Ueberspannung/Smoky/README.md

# Smoky
small hand-held smoke machine

Did you ever needed a small smoke machine for testing air flow in a computer case or around heat sinks?  
Well here it is:

## the smoke machine to go
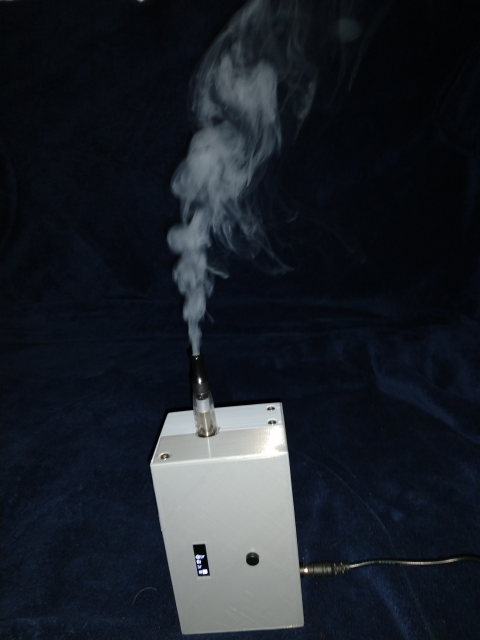
[picture p1: doc/img/thumb/assembly/640/Smoky_active.png]
smoky

- hand held ~ 83 x 64 x 132 (184) mm
- adjustable smoke output
- pulse mode (steam engine effect) 
- 128 x 32 oled with 5 way navigation button
- operating voltage 8-24V
- input voltage low detection

I tried it on smoke detectors: I works!  
> [!WARNING]  
> As the smoke is rather fog than smoke it consists of vaporized liquids which 
> may cause a residue in your smoke detector. Make shure to blow out the smoke 
> with compressed air after the test.  

##### Table of contents
- [motivation](#motivation)
- [hardware](./doc/hw.md#Table-of-contents)
	- [schematics](./doc/hw.md#schematics)
	- [parts](./doc/hw.md#parts)
	- [assembly](./doc/hw.md#assembly)
- [software](./doc/sw.md#Table-of-contents)
- [operation](./doc/operation.md#Table-of-contents)
	- [smoke liquid](./doc/operation.md#smoke-liquid)
	- [principle of operation](./doc/operation.md#principle-of-operation)
	- [menu icons](./doc/operation.md#menu-icons)
	- [menu structure](./doc/operation.md#menu-structure)

## motivation
while looking for a ready build smoke machine for air flow analyses I found  
- chinese smoke machines for party use for less then 30€, which are far to powerfull  
- small smoke machines for the intended use starting at ~50€ with usable models well above 100€  
- smoke machines for your garden model trains starting at ~ 100€  

I thougt the model smoke machines should be the right way to go. In an platform for railway modellists 
I found a hint to use an e-cigarette. This sounded plausible and I decided that this was the way to go. So I 
searched for e-cigarette, and parts. I found some cheap vape heads and added an usb powerd fish tank air pump.  
The concept was born  
To make it operational, I had to ad a PWM control for air flow and steam generation, a UI and a case,
For details see [hardware](./doc/hw.md#Table-of-contents) and the functional [description](./doc/operation.md#Table-of-contents)
