Ueberspannung/Smoky/doc/img/src/menu/Menu_1_0________main.png

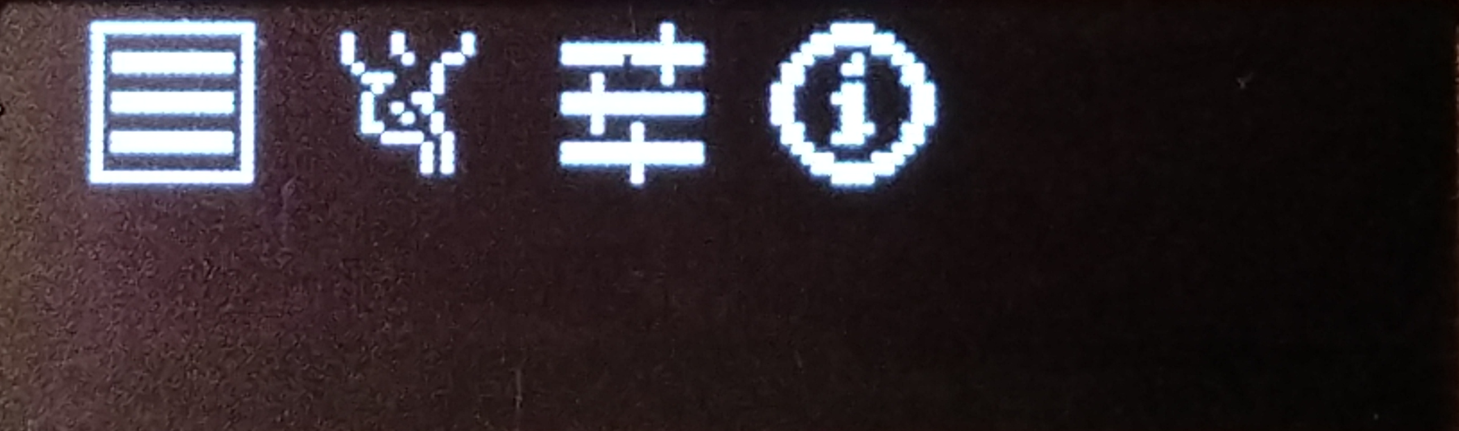
doc/img/src/menu/Menu_1_0________main.png
