Ueberspannung/Smoky/doc/img/src/menu/Menu_1_1_0______main-smoke-inactive.png

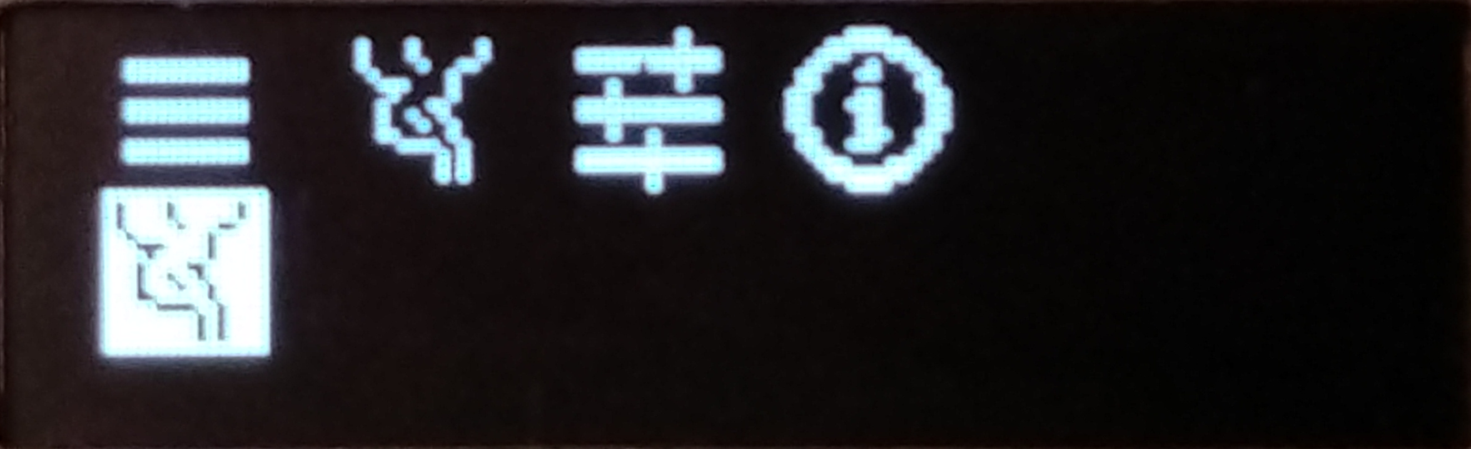
doc/img/src/menu/Menu_1_1_0______main-smoke-inactive.png
