Ueberspannung/Smoky/doc/img/src/menu/Menu_1_1_1______main-smoke-active.png

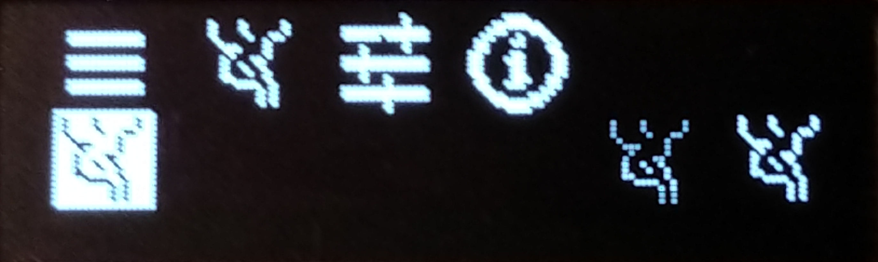
doc/img/src/menu/Menu_1_1_1______main-smoke-active.png
