Ueberspannung/Smoky/doc/img/src/menu/Menu_1_1________main-smoke.png

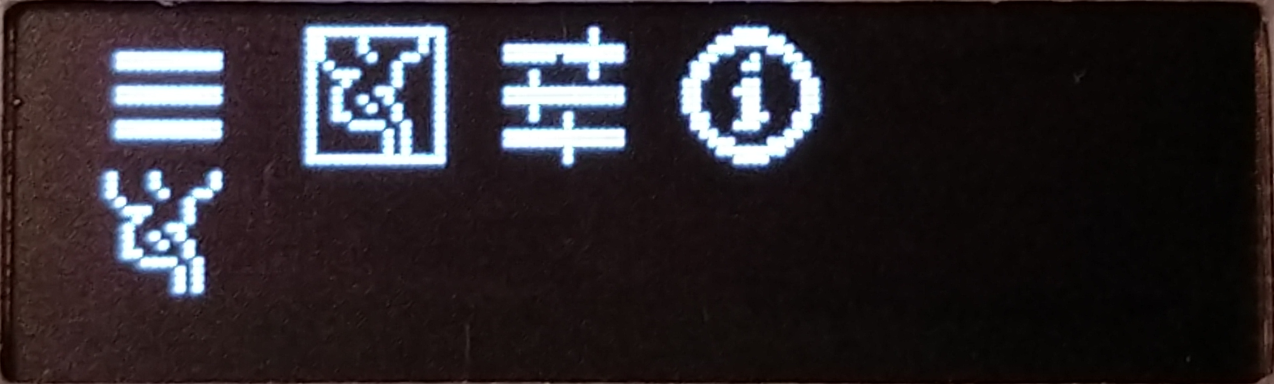
doc/img/src/menu/Menu_1_1________main-smoke.png
