Ueberspannung/Smoky/doc/img/src/menu/Menu_1_2_0______main-settings_menu.png

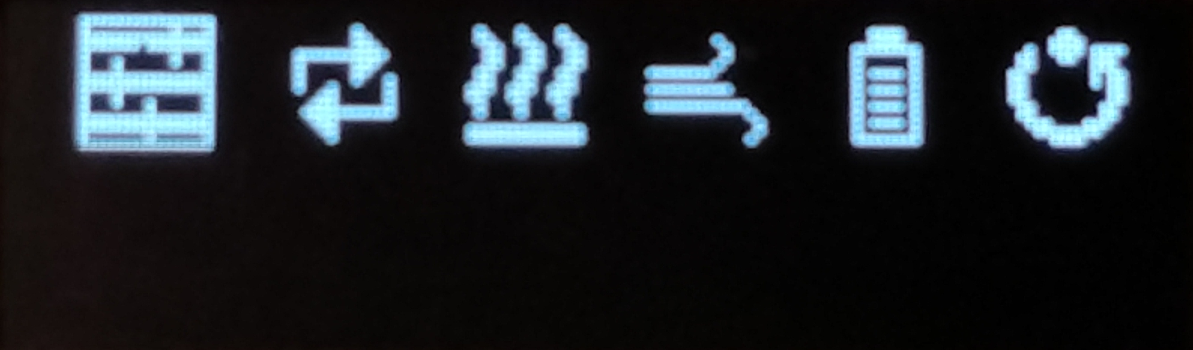
doc/img/src/menu/Menu_1_2_0______main-settings_menu.png
