Ueberspannung/Smoky/doc/img/src/menu/Menu_1_2_1_0____main-settings-cycle-menu.png

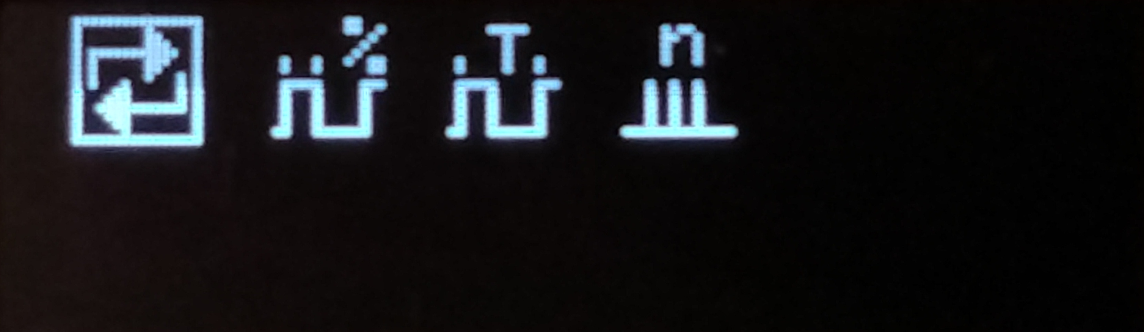
doc/img/src/menu/Menu_1_2_1_0____main-settings-cycle-menu.png
