Ueberspannung/Smoky/doc/img/src/menu/Menu_1_2_1_1____main-settings-cycle-duty_cycle.png

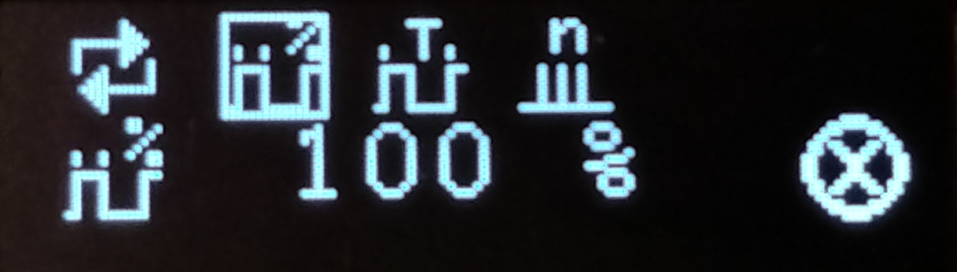
doc/img/src/menu/Menu_1_2_1_1____main-settings-cycle-duty_cycle.png
