Ueberspannung/Smoky/doc/img/src/menu/Menu_1_2_1_2____main-settings-cycle-periode.png

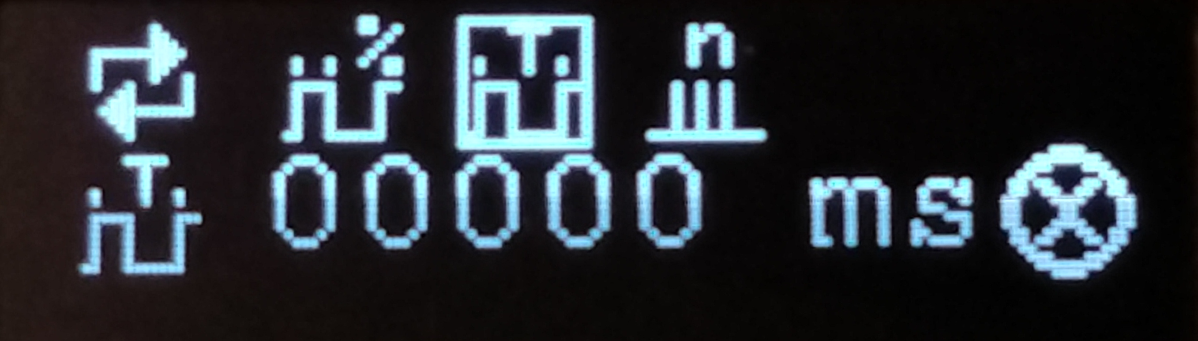
doc/img/src/menu/Menu_1_2_1_2____main-settings-cycle-periode.png
