Ueberspannung/Smoky/doc/img/src/menu/Menu_1_2_1_3_1__main-settings-cycle-cycles-edit.png

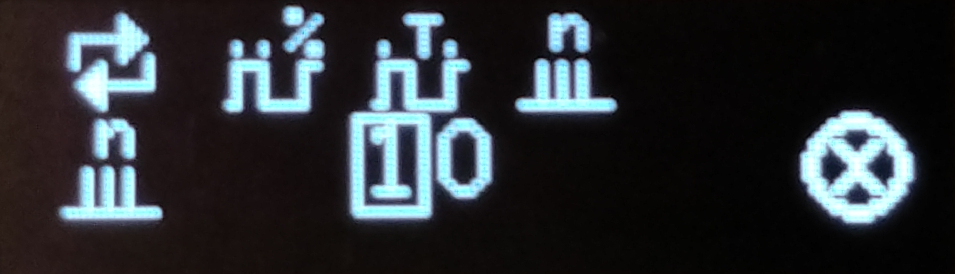
doc/img/src/menu/Menu_1_2_1_3_1__main-settings-cycle-cycles-edit.png
