Ueberspannung/Smoky/doc/img/src/menu/Menu_1_2_1_3____main-settings-cycle-cycles.png

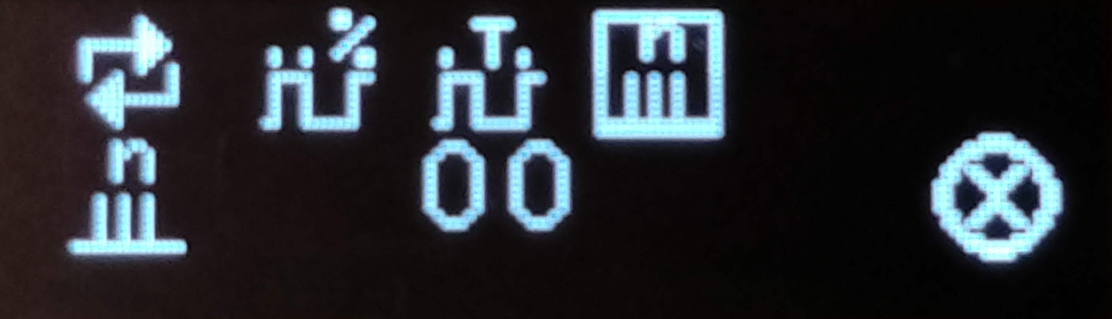
doc/img/src/menu/Menu_1_2_1_3____main-settings-cycle-cycles.png
