Ueberspannung/Smoky/doc/img/src/menu/Menu_1_2_1______main-settings-cycle.png

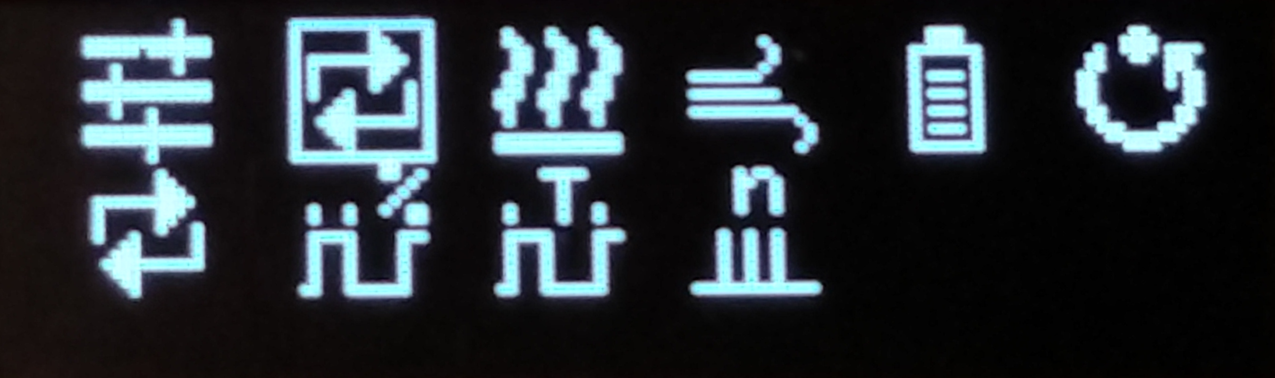
doc/img/src/menu/Menu_1_2_1______main-settings-cycle.png
