Ueberspannung/Smoky/doc/img/src/menu/Menu_1_2_2_0____main-settings-heat-menu.png

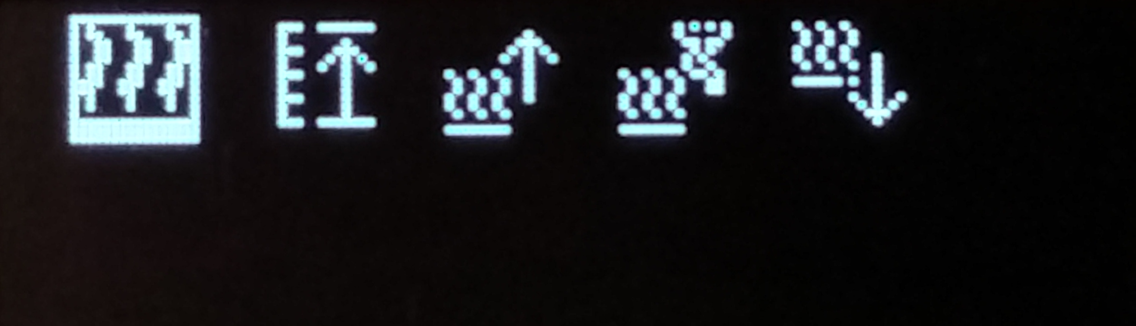
doc/img/src/menu/Menu_1_2_2_0____main-settings-heat-menu.png
