Ueberspannung/Smoky/doc/img/src/menu/Menu_1_2_2_1____main-settings-heat-power_limit.png

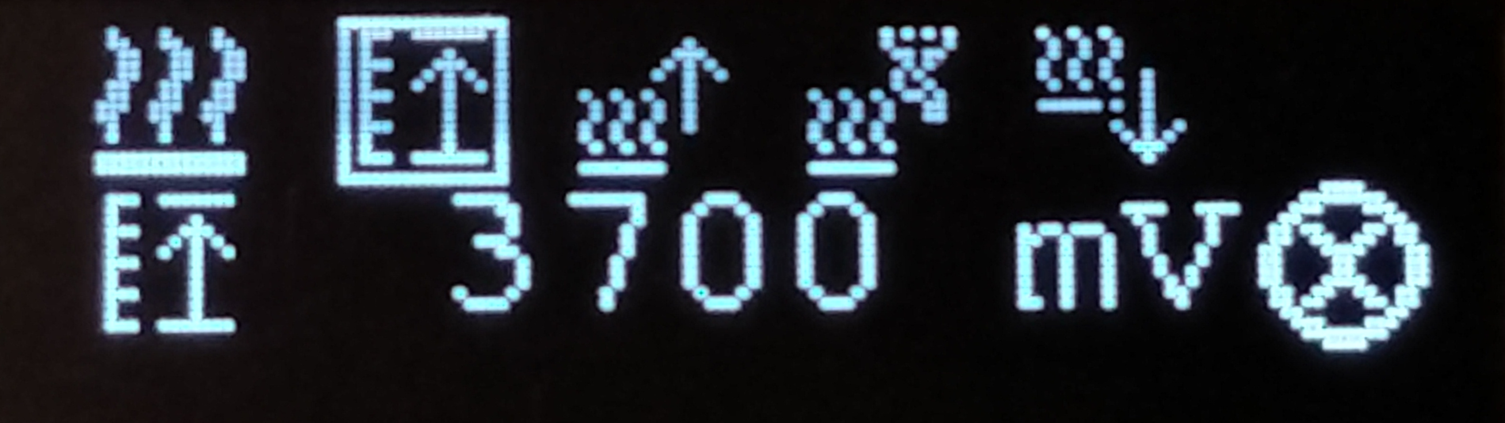
doc/img/src/menu/Menu_1_2_2_1____main-settings-heat-power_limit.png
