Ueberspannung/Smoky/doc/img/src/menu/Menu_1_2_2_2_0__main-settings-heat-start-menu.png

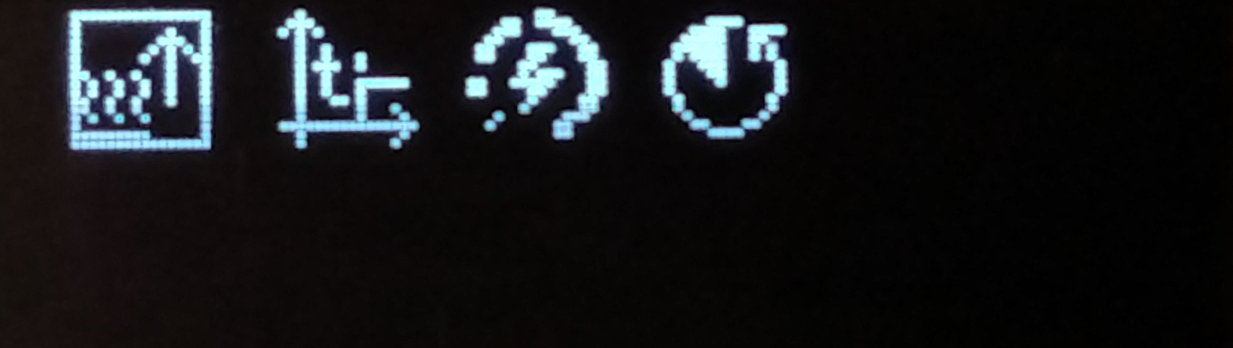
doc/img/src/menu/Menu_1_2_2_2_0__main-settings-heat-start-menu.png
