Ueberspannung/Smoky/doc/img/src/menu/Menu_1_2_2_2_1__main-settings-heat-start-delay.png

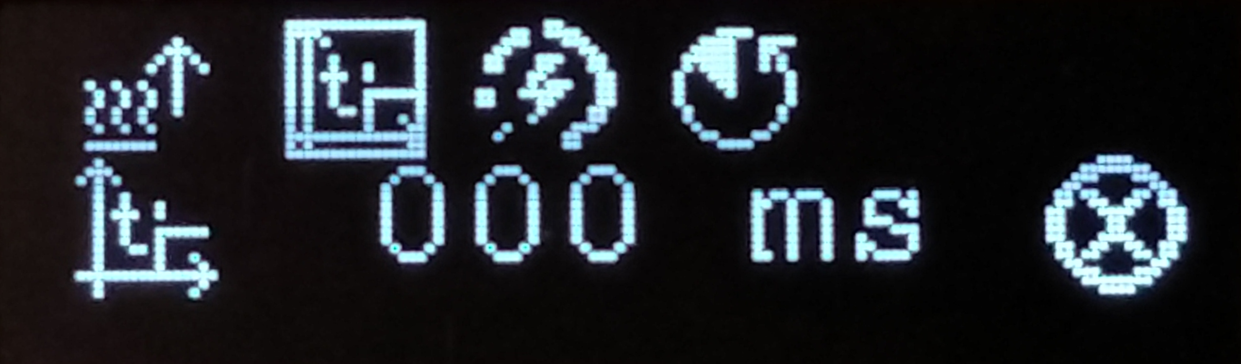
doc/img/src/menu/Menu_1_2_2_2_1__main-settings-heat-start-delay.png
