Ueberspannung/Smoky/doc/img/src/menu/Menu_1_2_2_2_2__main-settings-heat-start-power.png

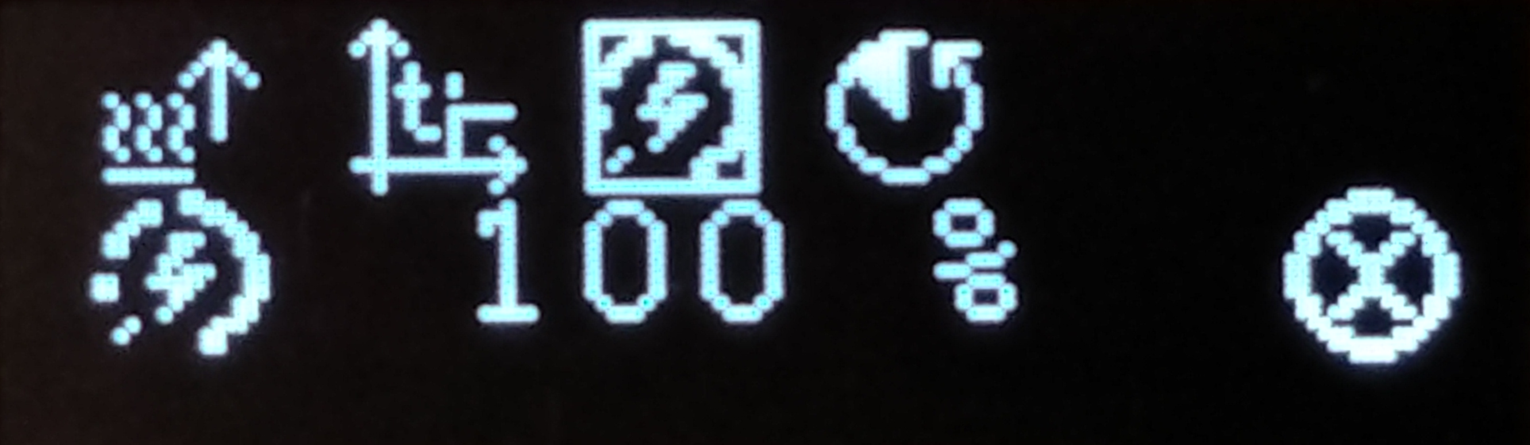
doc/img/src/menu/Menu_1_2_2_2_2__main-settings-heat-start-power.png
