Ueberspannung/Smoky/doc/img/src/menu/Menu_1_2_2_2_3__main-settings-heat-start-duration.png

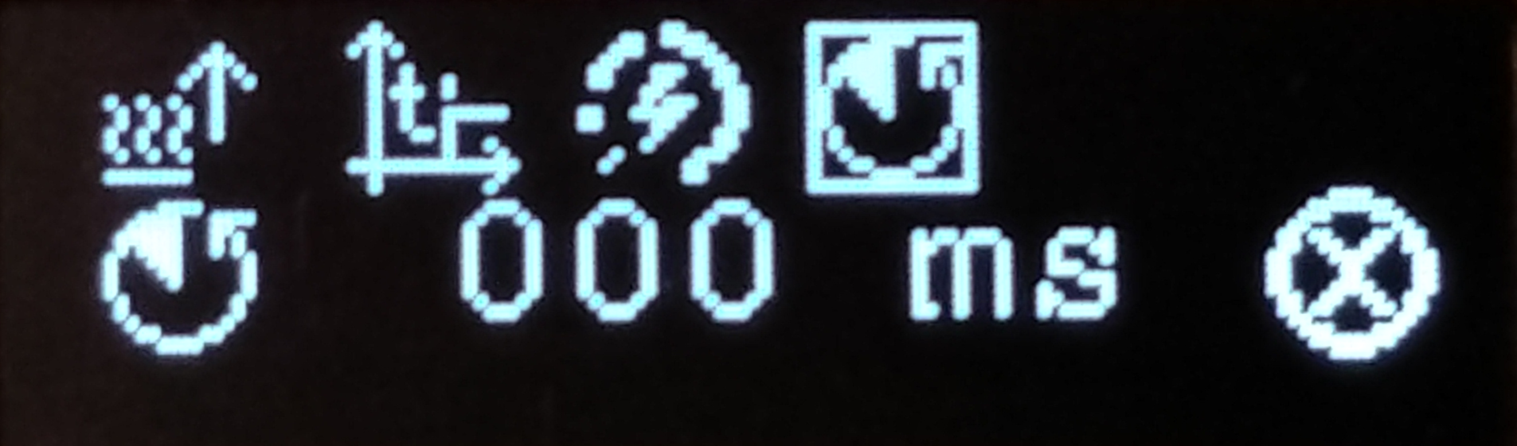
doc/img/src/menu/Menu_1_2_2_2_3__main-settings-heat-start-duration.png
