Ueberspannung/Smoky/doc/img/src/menu/Menu_1_2_2_2____main-settings-heat-start.png

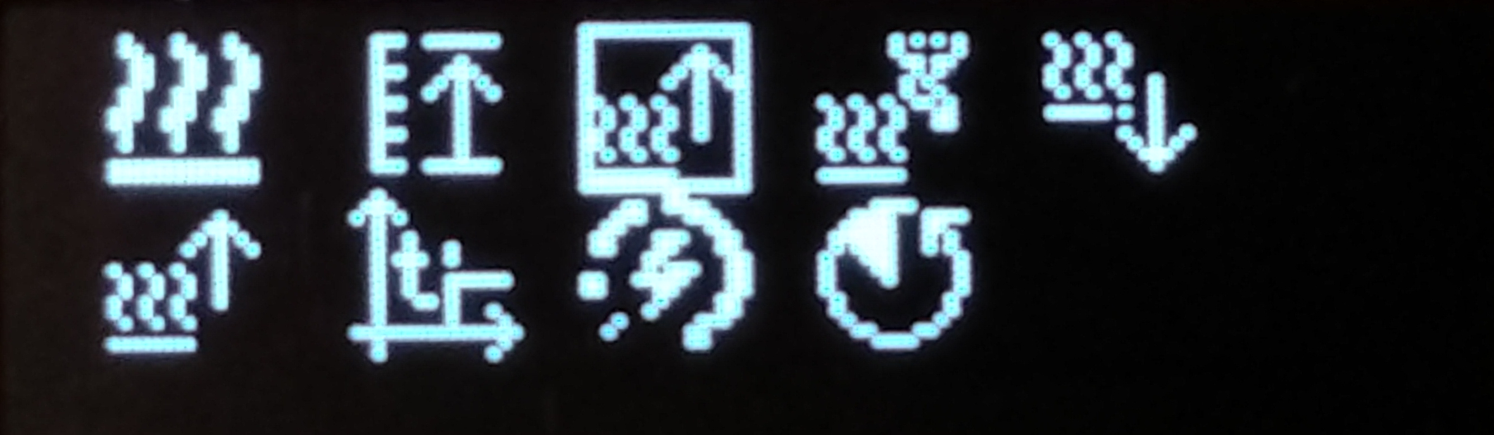
doc/img/src/menu/Menu_1_2_2_2____main-settings-heat-start.png
