Ueberspannung/Smoky/doc/img/src/menu/Menu_1_2_2_3____main-settings-heat-run.png

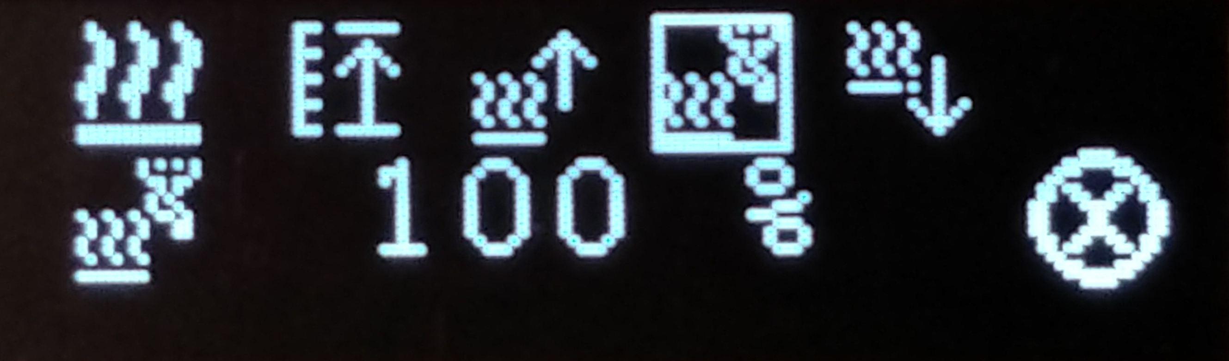
doc/img/src/menu/Menu_1_2_2_3____main-settings-heat-run.png
