Ueberspannung/Smoky/doc/img/src/menu/Menu_1_2_2_4_0__main-settings-heat-stop-menu.png

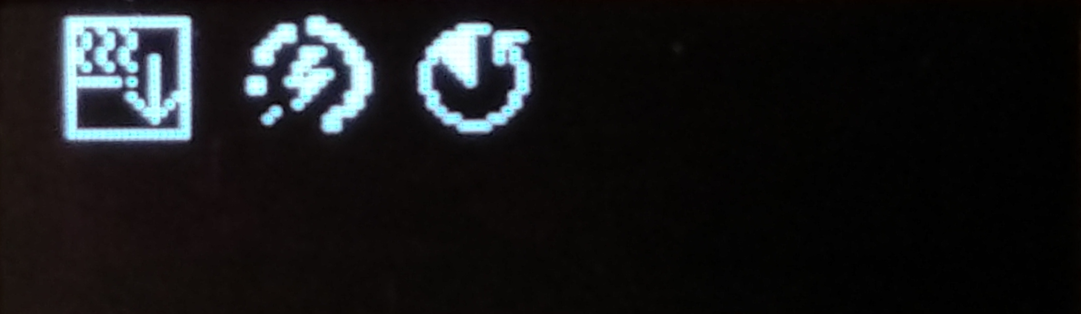
doc/img/src/menu/Menu_1_2_2_4_0__main-settings-heat-stop-menu.png
