Ueberspannung/Smoky/doc/img/src/menu/Menu_1_2_2_4_1__main-settings-heat-stop-power.png

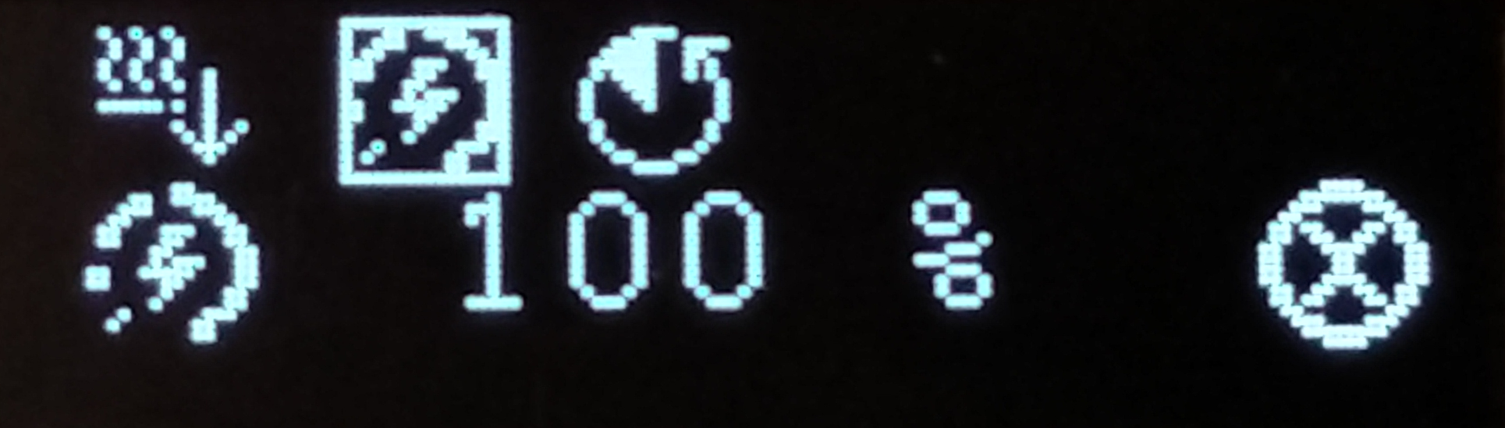
doc/img/src/menu/Menu_1_2_2_4_1__main-settings-heat-stop-power.png
