Ueberspannung/Smoky/doc/img/src/menu/Menu_1_2_2_4_2__main-settings-heat-stop-duration.png

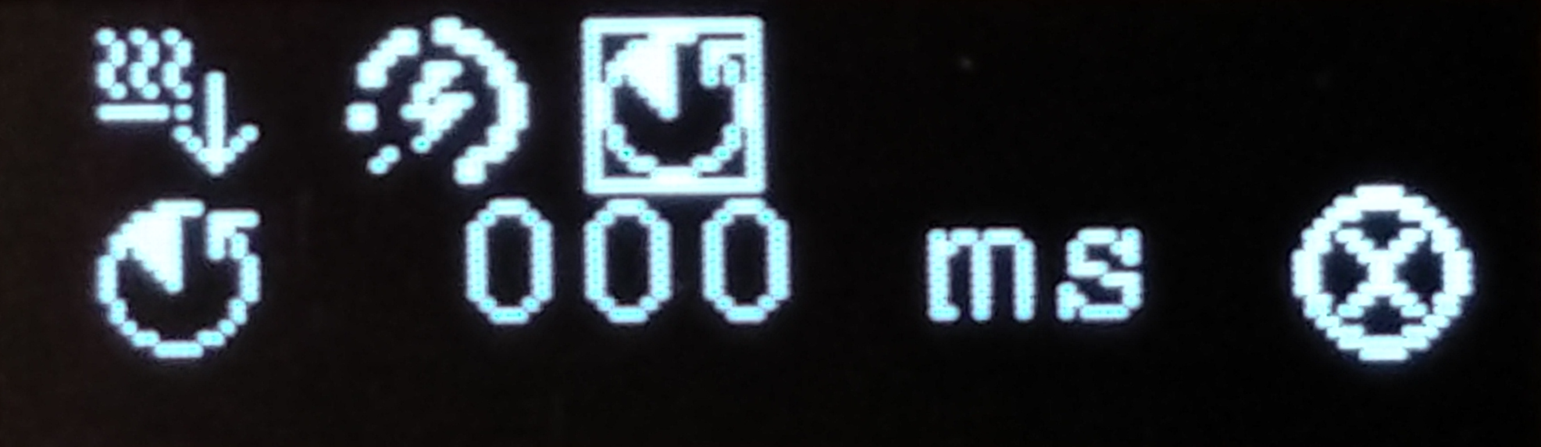
doc/img/src/menu/Menu_1_2_2_4_2__main-settings-heat-stop-duration.png
