Ueberspannung/Smoky/doc/img/src/menu/Menu_1_2_2_4____main-settings-heat-stop.png

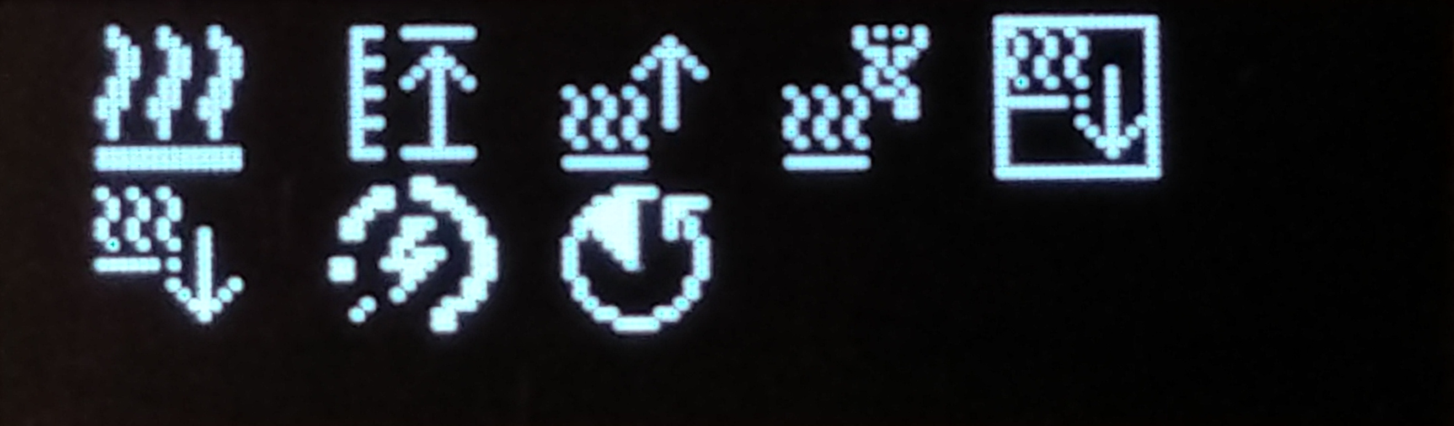
doc/img/src/menu/Menu_1_2_2_4____main-settings-heat-stop.png
