Ueberspannung/Smoky/doc/img/src/menu/Menu_1_2_2______main-settings-heat.png

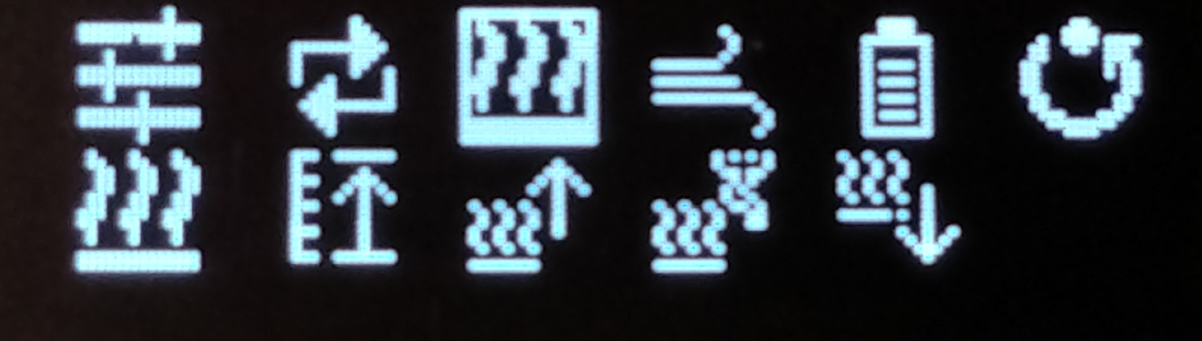
doc/img/src/menu/Menu_1_2_2______main-settings-heat.png
