Ueberspannung/Smoky/doc/img/src/menu/Menu_1_2_3_0____main-settings-air-menu.png

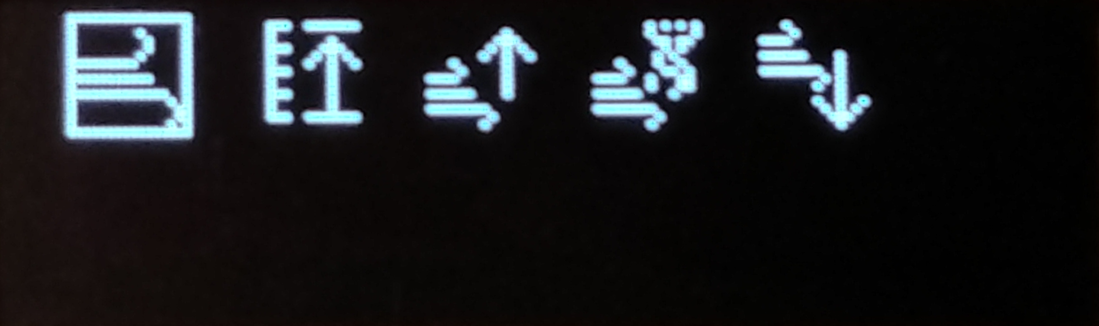
doc/img/src/menu/Menu_1_2_3_0____main-settings-air-menu.png
