Ueberspannung/Smoky/doc/img/src/menu/Menu_1_2_3_1____main-settings-air-power_limit.png

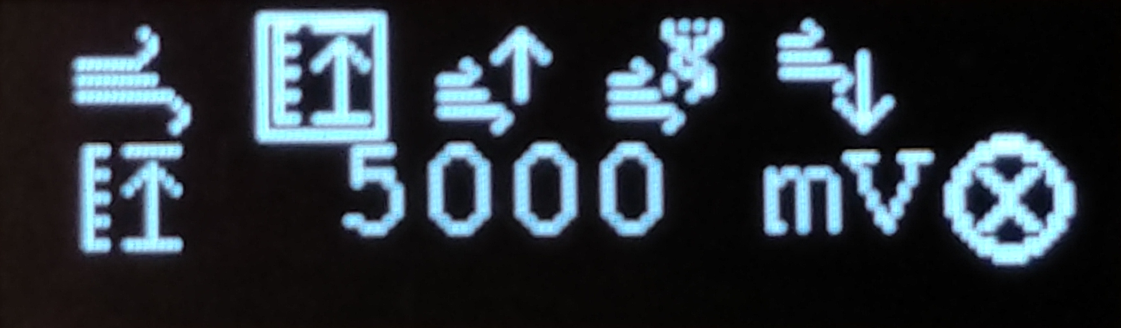
doc/img/src/menu/Menu_1_2_3_1____main-settings-air-power_limit.png
