Ueberspannung/Smoky/doc/img/src/menu/Menu_1_2_3_2_3__main-settings-air-start-duration.png

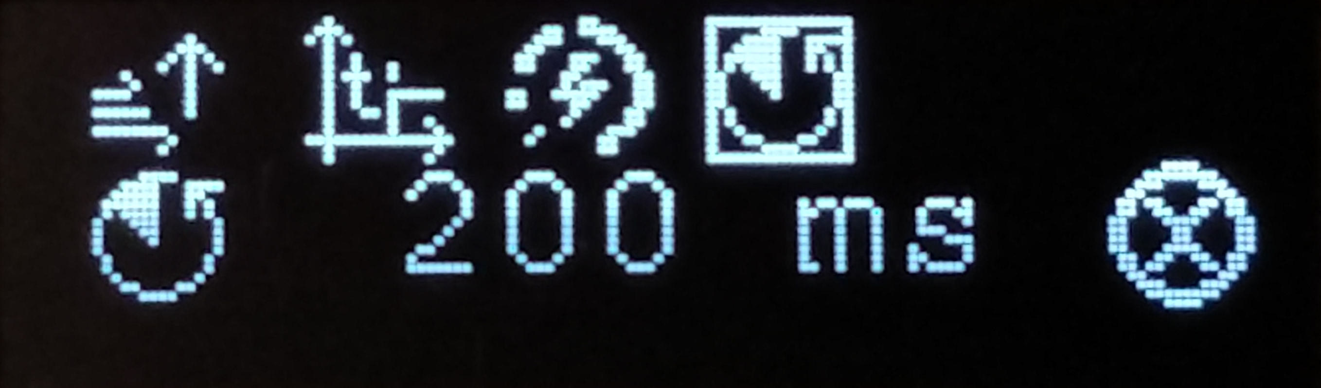
doc/img/src/menu/Menu_1_2_3_2_3__main-settings-air-start-duration.png
