Ueberspannung/Smoky/doc/img/src/menu/Menu_1_2_3_2____main-settings-air-start.png

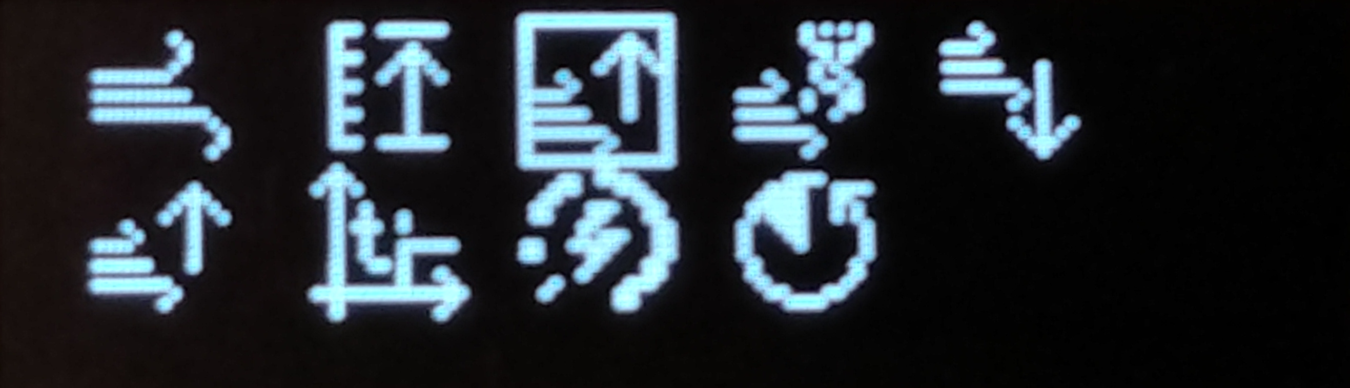
doc/img/src/menu/Menu_1_2_3_2____main-settings-air-start.png
