Ueberspannung/Smoky/doc/img/src/menu/Menu_1_2_3_3____main-settings-air-run.png

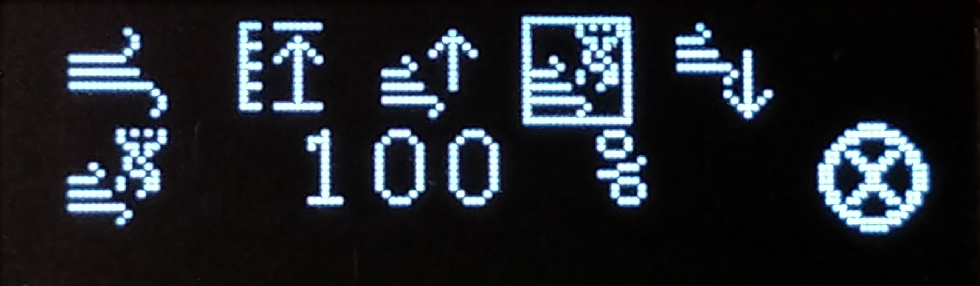
doc/img/src/menu/Menu_1_2_3_3____main-settings-air-run.png
