Ueberspannung/Smoky/doc/img/src/menu/Menu_1_2_3_4____main-settings-air-stop.png

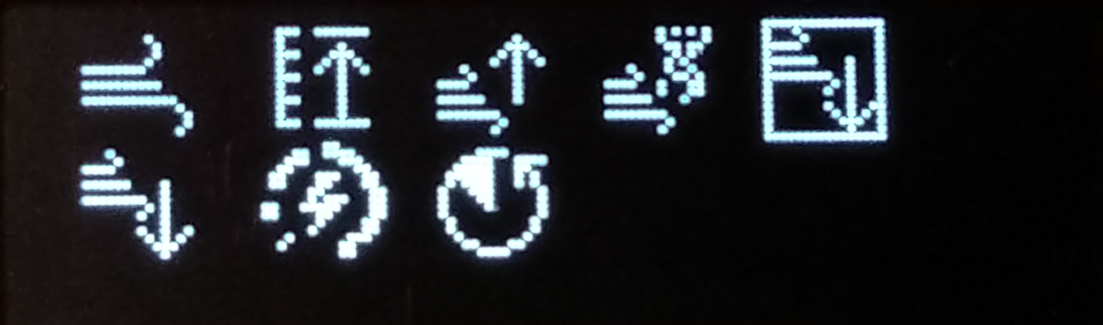
doc/img/src/menu/Menu_1_2_3_4____main-settings-air-stop.png
