Ueberspannung/Smoky/doc/img/src/menu/Menu_1_2_3______main-settings-air.png

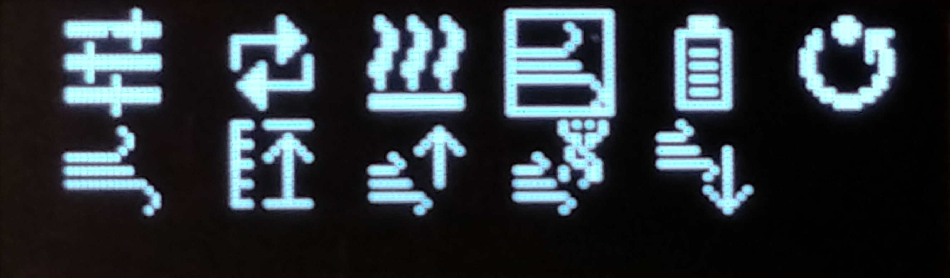
doc/img/src/menu/Menu_1_2_3______main-settings-air.png
