Ueberspannung/Smoky/doc/img/src/menu/Menu_1_2_4_0____main-settings-battery-menu.png

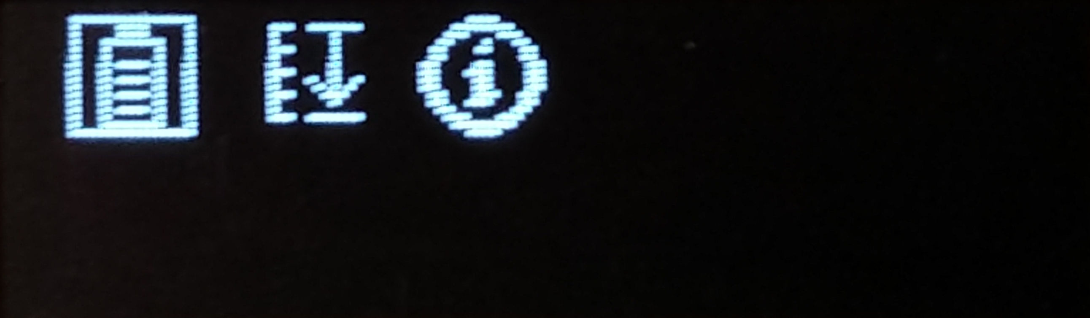
doc/img/src/menu/Menu_1_2_4_0____main-settings-battery-menu.png
