Ueberspannung/Smoky/doc/img/src/menu/Menu_1_2_4_1____main-settings-battery-low_limit.png

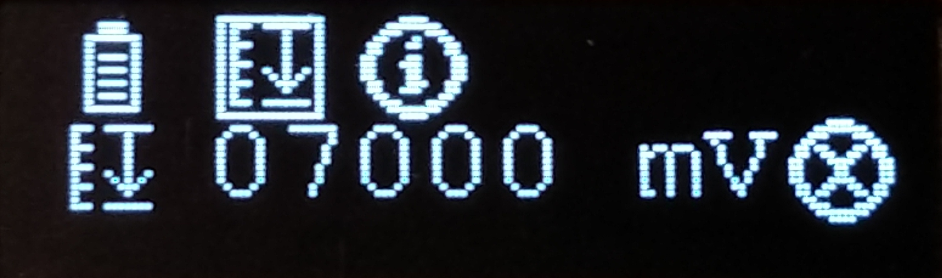
doc/img/src/menu/Menu_1_2_4_1____main-settings-battery-low_limit.png
