Ueberspannung/Smoky/doc/img/src/menu/Menu_1_2_4_2____main-settings-battery-input_voltage.png

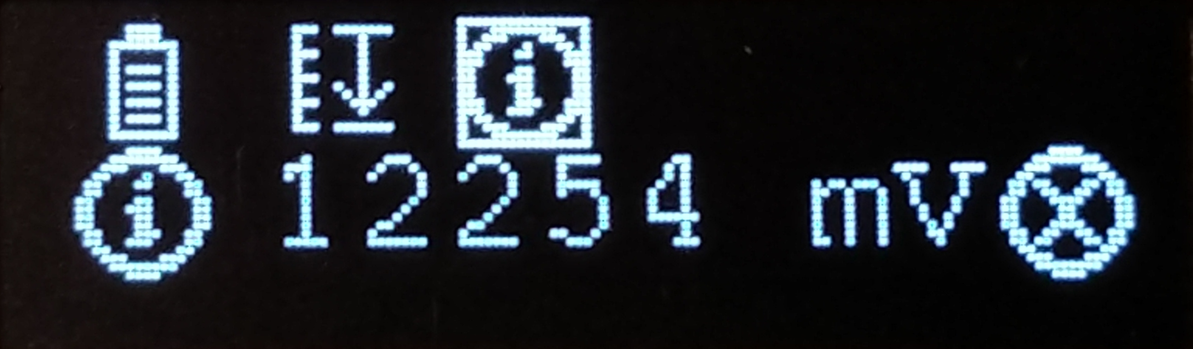
doc/img/src/menu/Menu_1_2_4_2____main-settings-battery-input_voltage.png
