Ueberspannung/Smoky/doc/img/src/menu/Menu_1_2_4_3____main-settings-battery-input_voltage_low.png

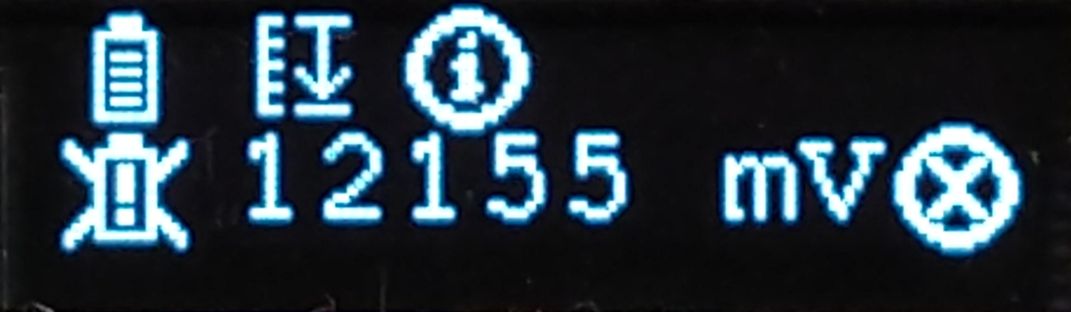
doc/img/src/menu/Menu_1_2_4_3____main-settings-battery-input_voltage_low.png
