Ueberspannung/Smoky/doc/img/src/menu/Menu_1_2_4______main-settings-battery.png

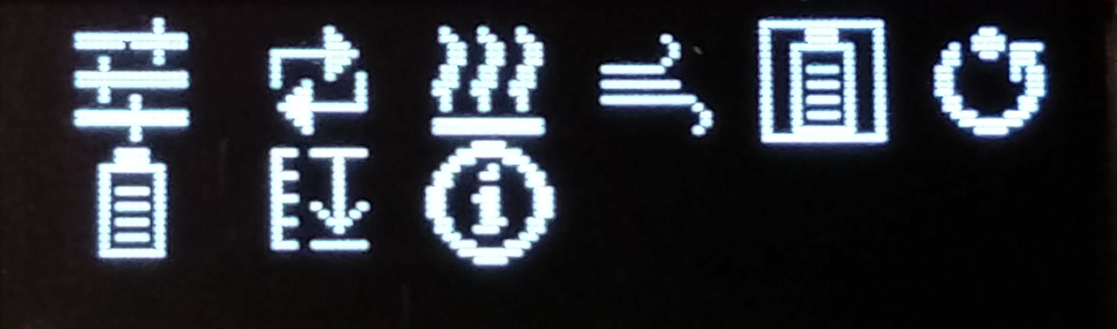
doc/img/src/menu/Menu_1_2_4______main-settings-battery.png
