Ueberspannung/Smoky/doc/img/src/menu/Menu_1_2_5______main-settings-reset.png

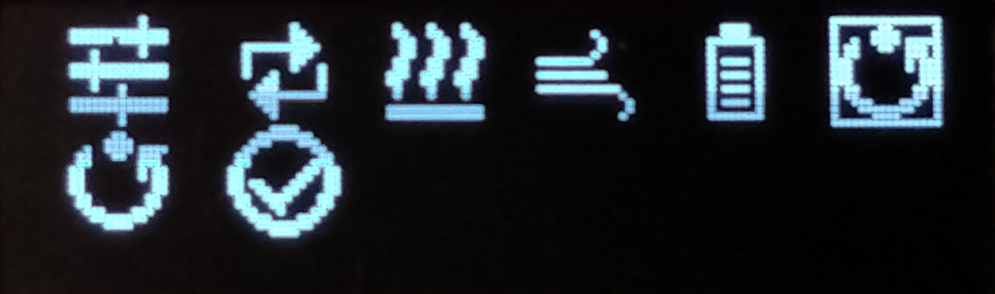
doc/img/src/menu/Menu_1_2_5______main-settings-reset.png
