Ueberspannung/Smoky/doc/img/src/menu/Menu_1_2________main-settings.png

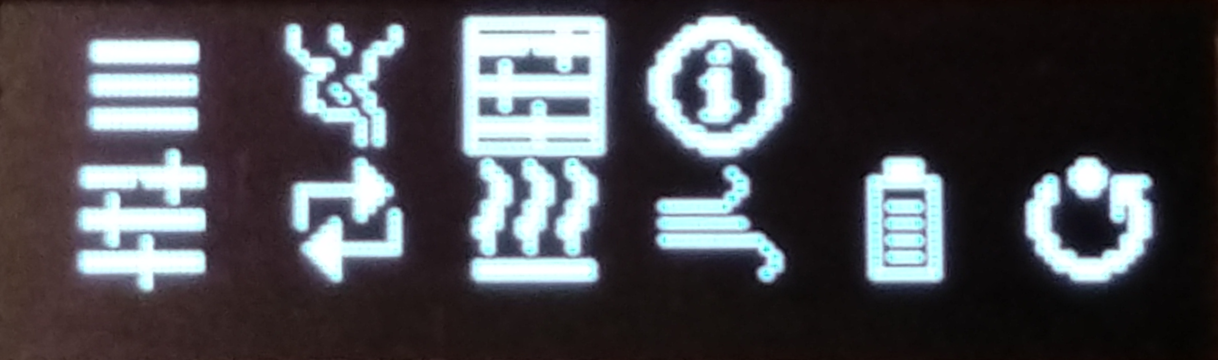
doc/img/src/menu/Menu_1_2________main-settings.png
