Ueberspannung/Smoky/doc/img/src/menu/Menu_1_3________main-info.png

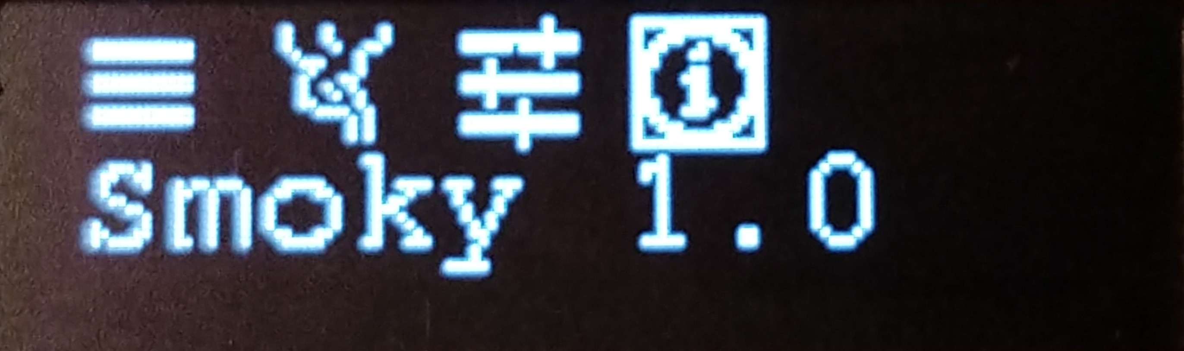
doc/img/src/menu/Menu_1_3________main-info.png
