Ueberspannung/Smoky/doc/img/src/parts/schematic.png

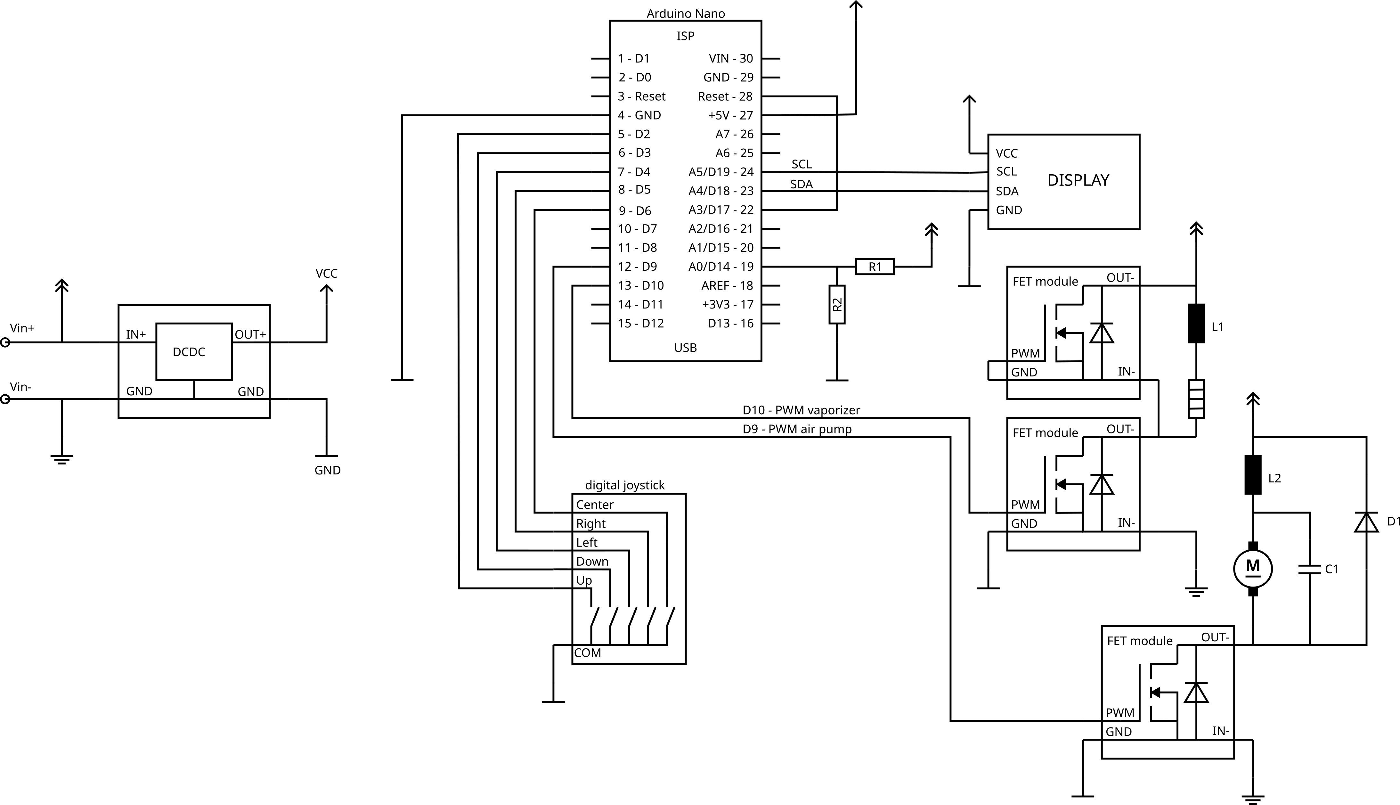
doc/img/src/parts/schematic.png
