Ueberspannung/Smoky/doc/img/src/parts/Capacitor_100nF.png

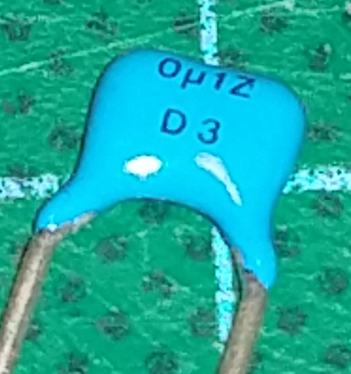
doc/img/src/parts/Capacitor_100nF.png
