Ueberspannung/Smoky/doc/img/src/parts/control.png

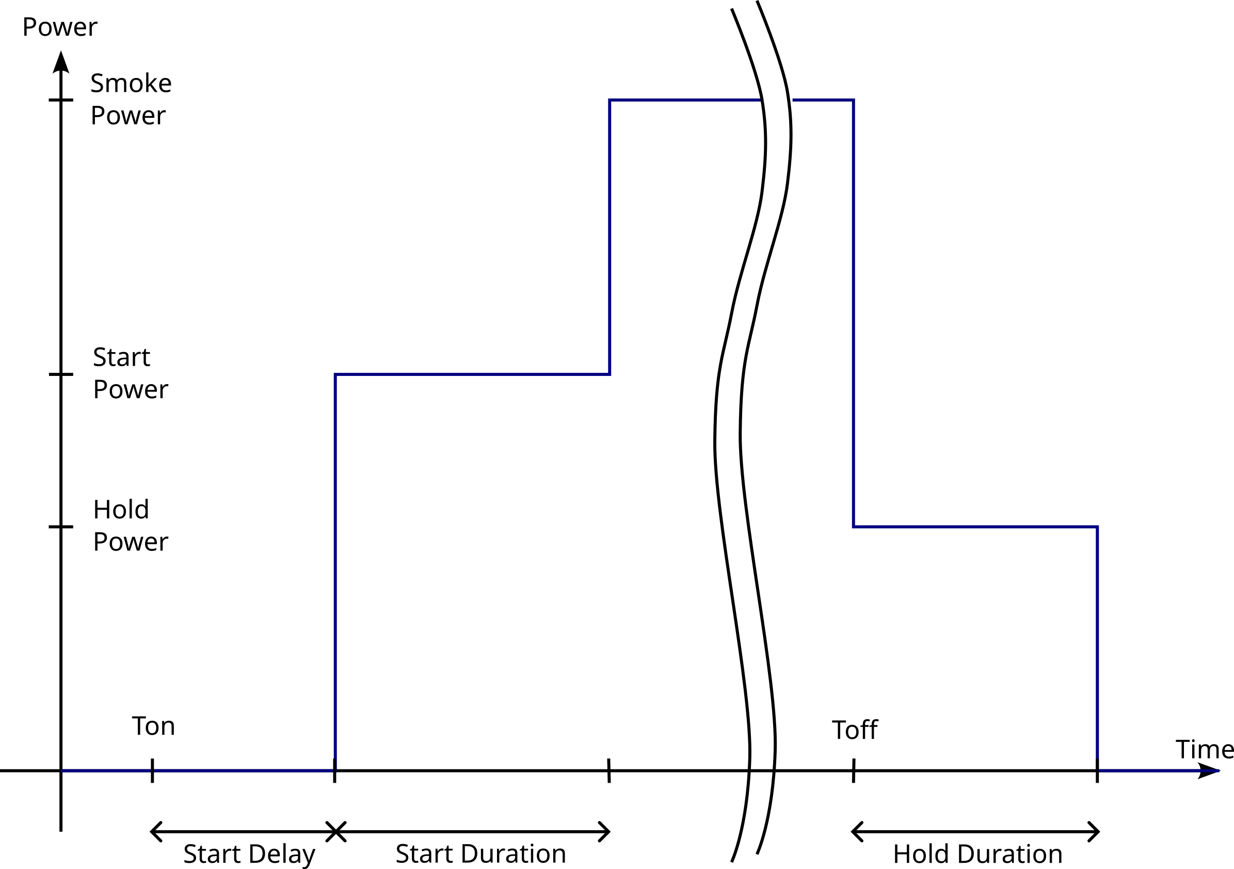
doc/img/src/parts/control.png
