Ueberspannung/Smoky/doc/img/src/parts/Diode_1N4150.png

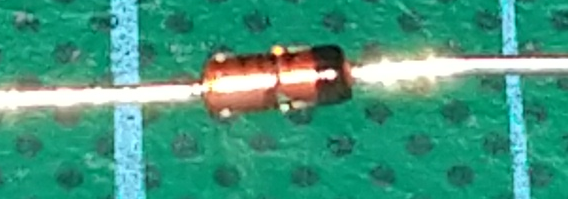
doc/img/src/parts/Diode_1N4150.png
