Ueberspannung/Smoky/doc/img/src/parts/Power_Rail_5V.png

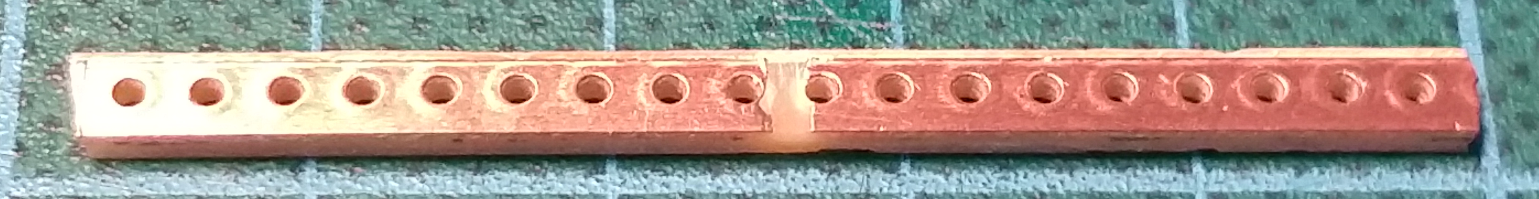
doc/img/src/parts/Power_Rail_5V.png
