Ueberspannung/Smoky/doc/img/src/parts/SSD1306_128x32.png

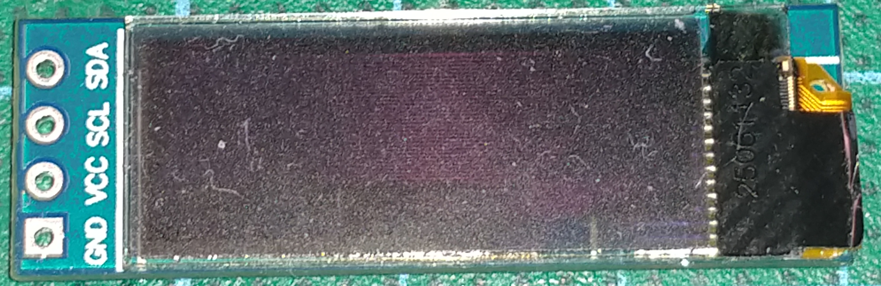
doc/img/src/parts/SSD1306_128x32.png
