Ueberspannung/Smoky/doc/img/src/parts/Vape_with_leads.png

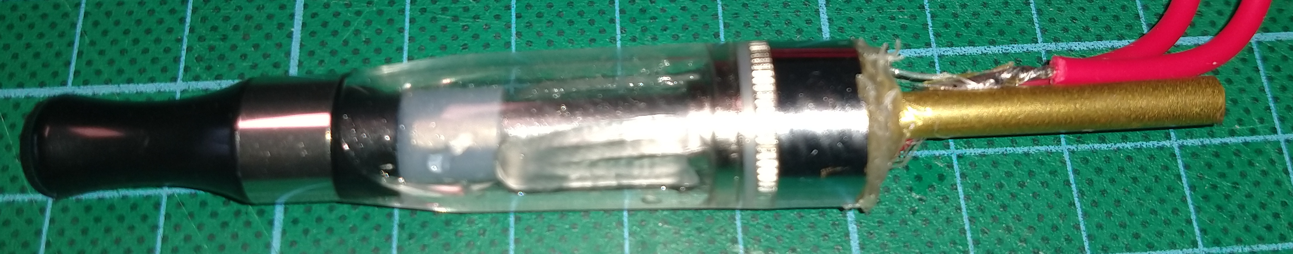
doc/img/src/parts/Vape_with_leads.png
