Ueberspannung/Smoky/doc/img/src/parts/Vape_wo_leads.png

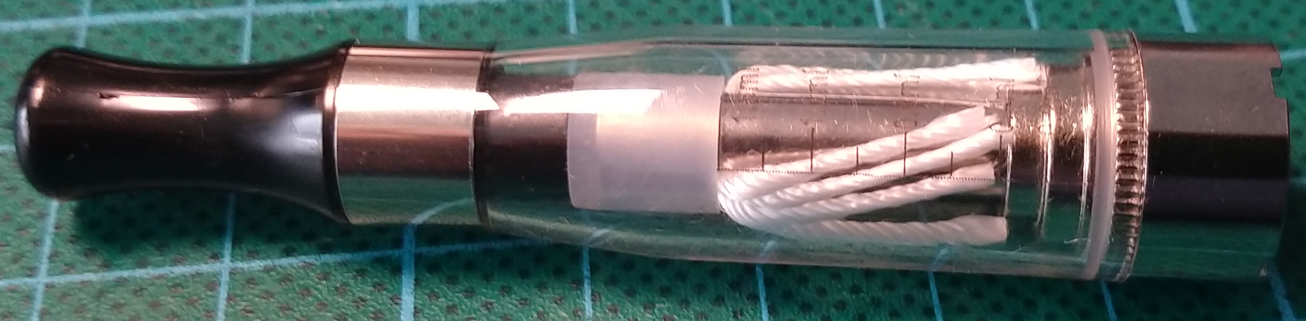
doc/img/src/parts/Vape_wo_leads.png
