Ueberspannung/Smoky/doc/img/src/assembly/Smoky_motor_assembly.png

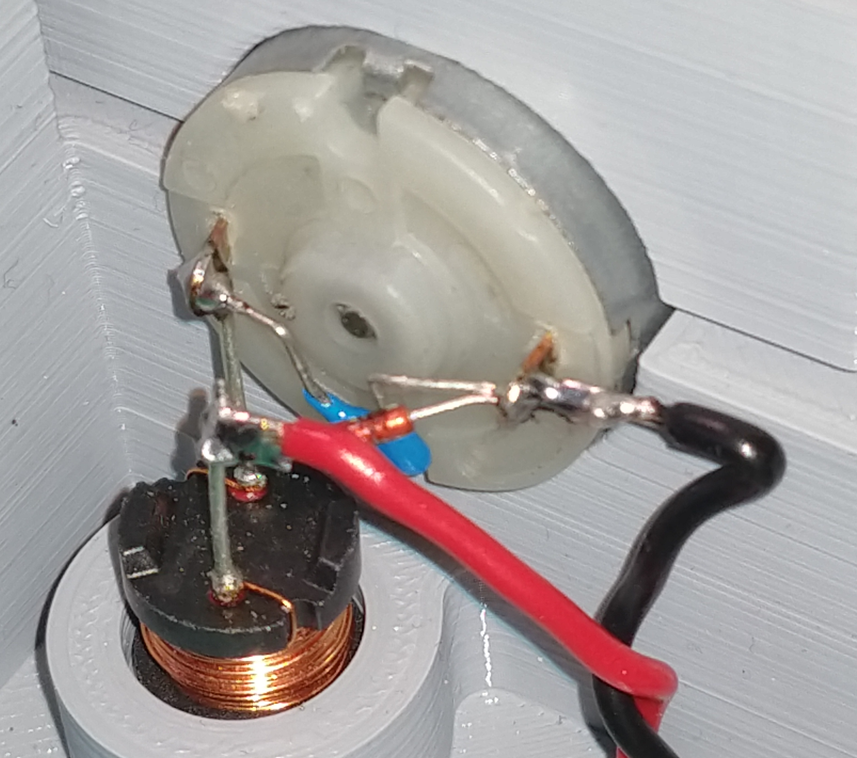
doc/img/src/assembly/Smoky_motor_assembly.png
