Ueberspannung/Smoky/smoky/src/UI/icondefs.h

static const uint8_t cMenu::iconData[iconListEnd][iconSize] PROGMEM =
															{	// Icon List
																{	// Menu Icon
																	0b00000000, 0b00000000,		//  0
																	0b00000000, 0b00000000,		//  1
																	0b00000000, 0b00000000,		//  2
																	0b00111111, 0b11111100,		//  3
																	0b00111111, 0b11111100,		//  4
																	0b00000000, 0b00000000,		//  5
																	0b00000000, 0b00000000,		//  6
																	0b00111111, 0b11111100,		//  7
																	0b00111111, 0b11111100,		//  8
																	0b00000000, 0b00000000,		//  9
																	0b00000000, 0b00000000,		// 10
																	0b00111111, 0b11111100,		// 11
																	0b00111111, 0b11111100,		// 12
																	0b00000000, 0b00000000,		// 13
																	0b00000000, 0b00000000,		// 14
																	0b00000000, 0b00000000},	// 15
																{	// Smoke Icon
																	0b00000000, 0b00000000,		//  0
																	0b01000010, 0b00000100,		//  1
																	0b01000010, 0b00000100,		//  2
																	0b01000001, 0b00011000,		//  3
																	0b00100000, 0b00100000,		//  4
																	0b00011100, 0b00100000,		//  5
																	0b00001000, 0b00100000,		//  6
																	0b00010000, 0b11000000,		//  7
																	0b00010010, 0b01000000,		//  8
																	0b00010001, 0b00100000,		//  9
																	0b00011000, 0b00100000,		// 10
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
																	0b00000000, 0b00000000,		// 11
																	0b00000000, 0b00000000,		// 12
																	0b00000000, 0b00000000,		// 13
																	0b00000000, 0b00000000,		// 14
																	0b00000000, 0b00000000},	// 15
																************************************ */
